sai021/dragon-den/dragon-masks/01-board-photo-reference.png

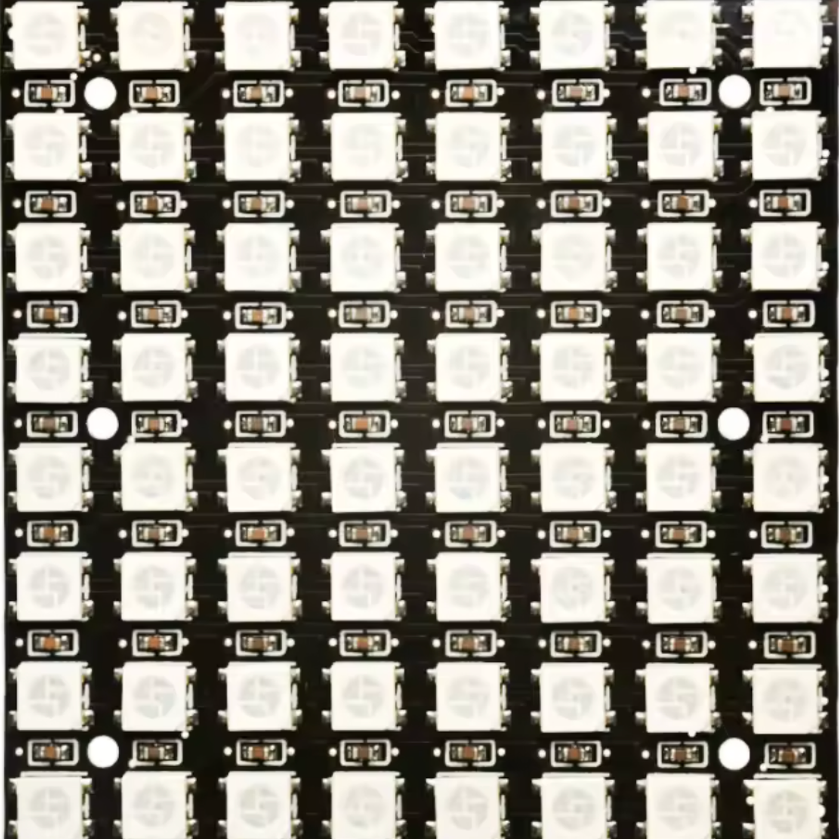
dragon-masks/01-board-photo-reference.png
