sai021/dragon-den/dragon-masks/10-shaded-art-reference.png

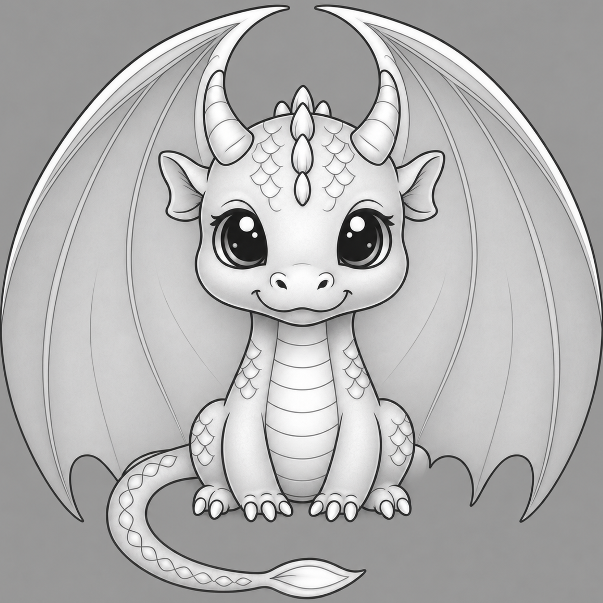
dragon-masks/10-shaded-art-reference.png
