sai021/dragon-den/dragon-firmware/hardware/review-2026-09-21/R4-connection.png

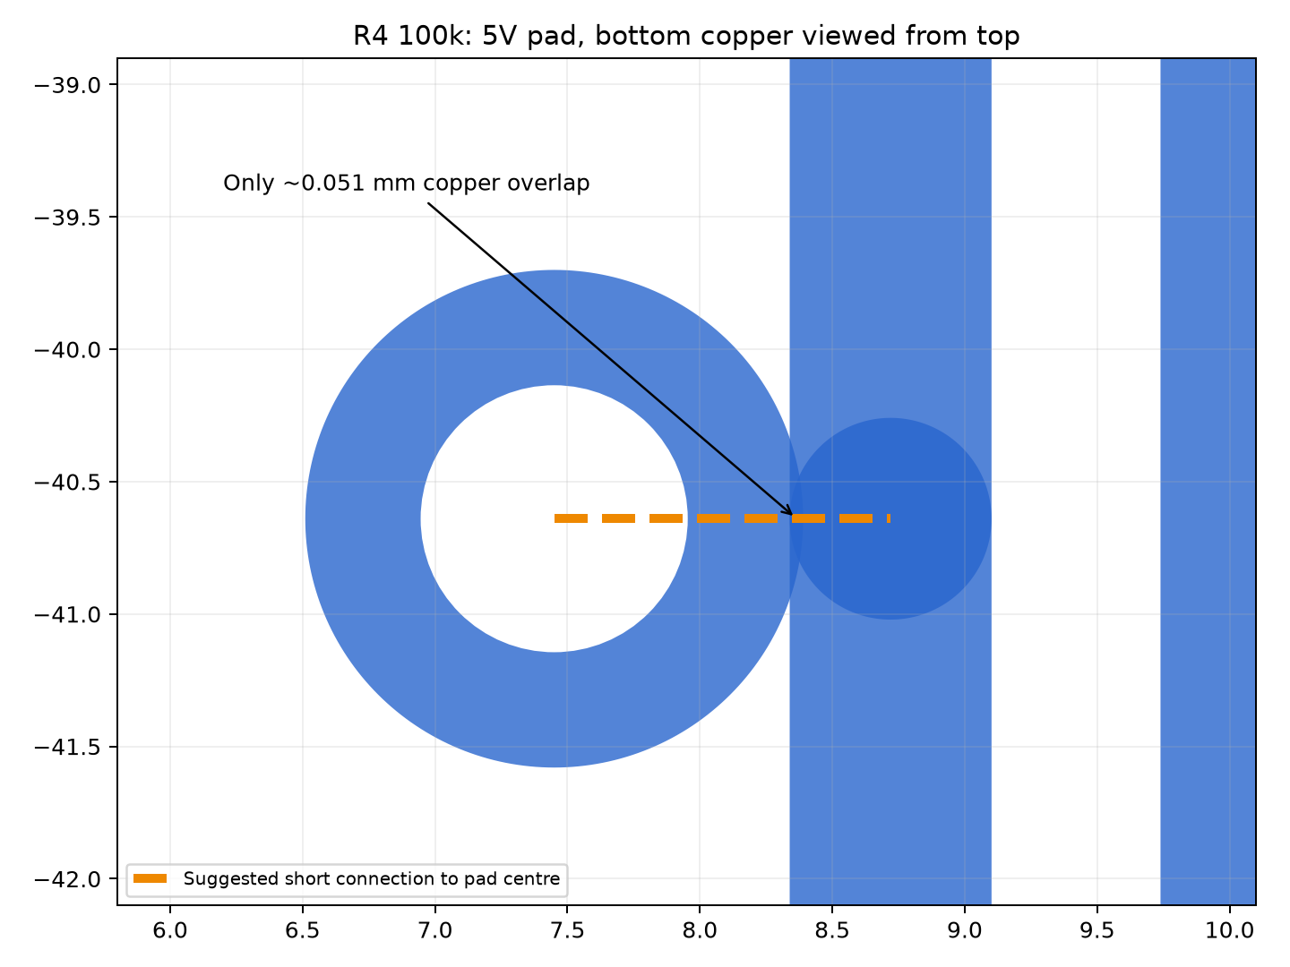
dragon-firmware/hardware/review-2026-09-21/R4-connection.png
