sai021/dragon-den/dragon-masks/01-led-package-mask.png

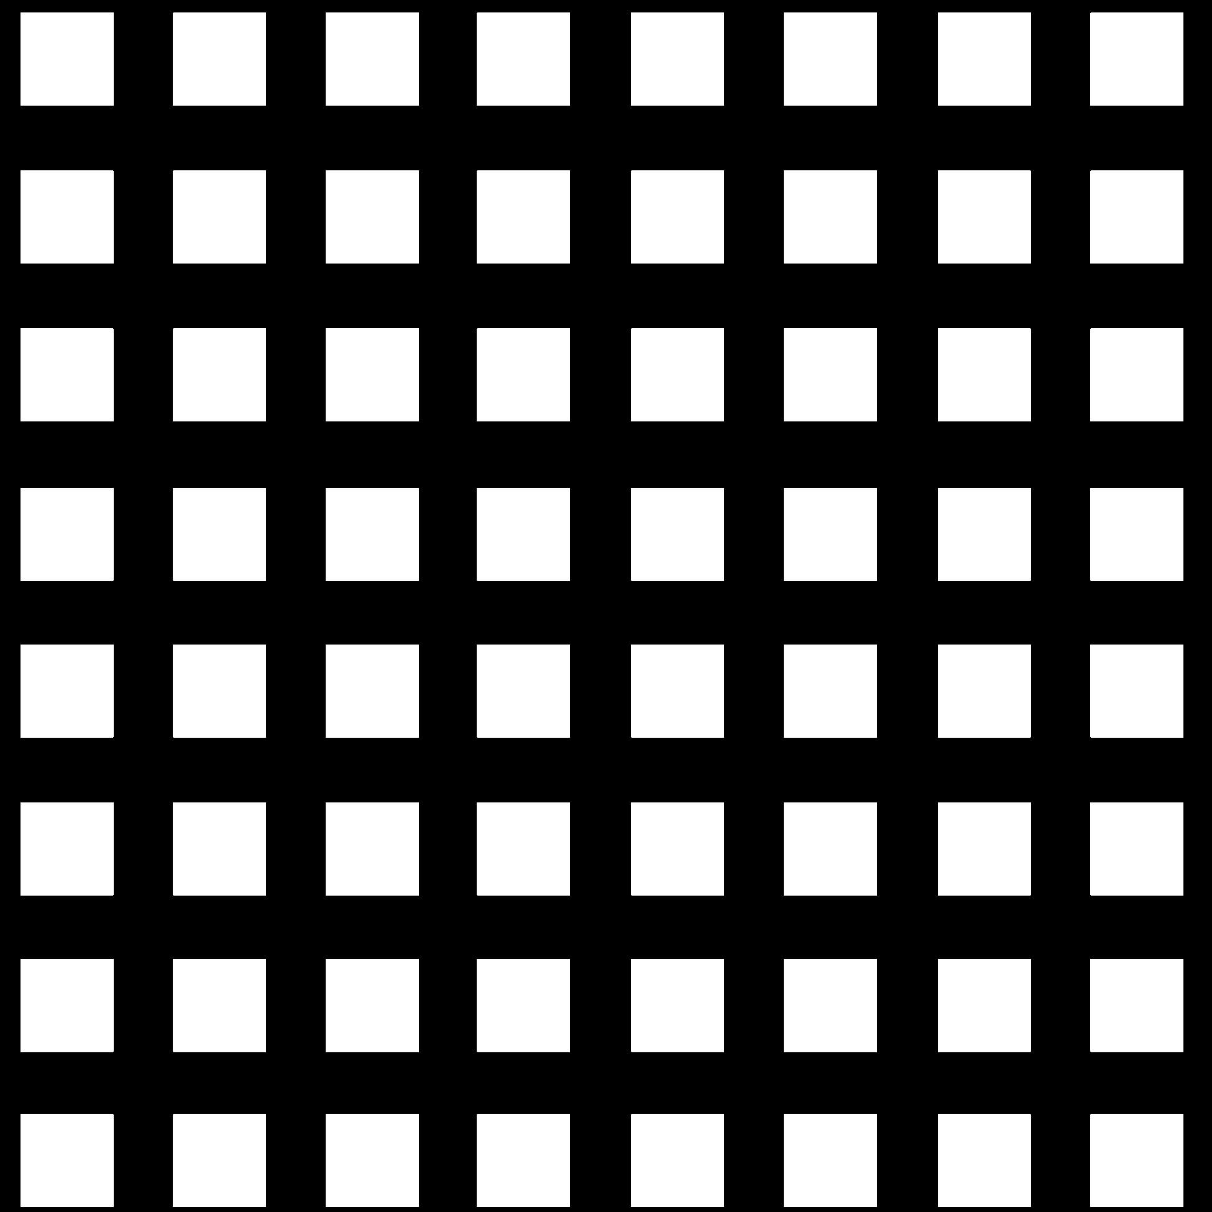
dragon-masks/01-led-package-mask.png
