sai021/dragon-den/dragon-masks/02-led-side-partition-mask.png

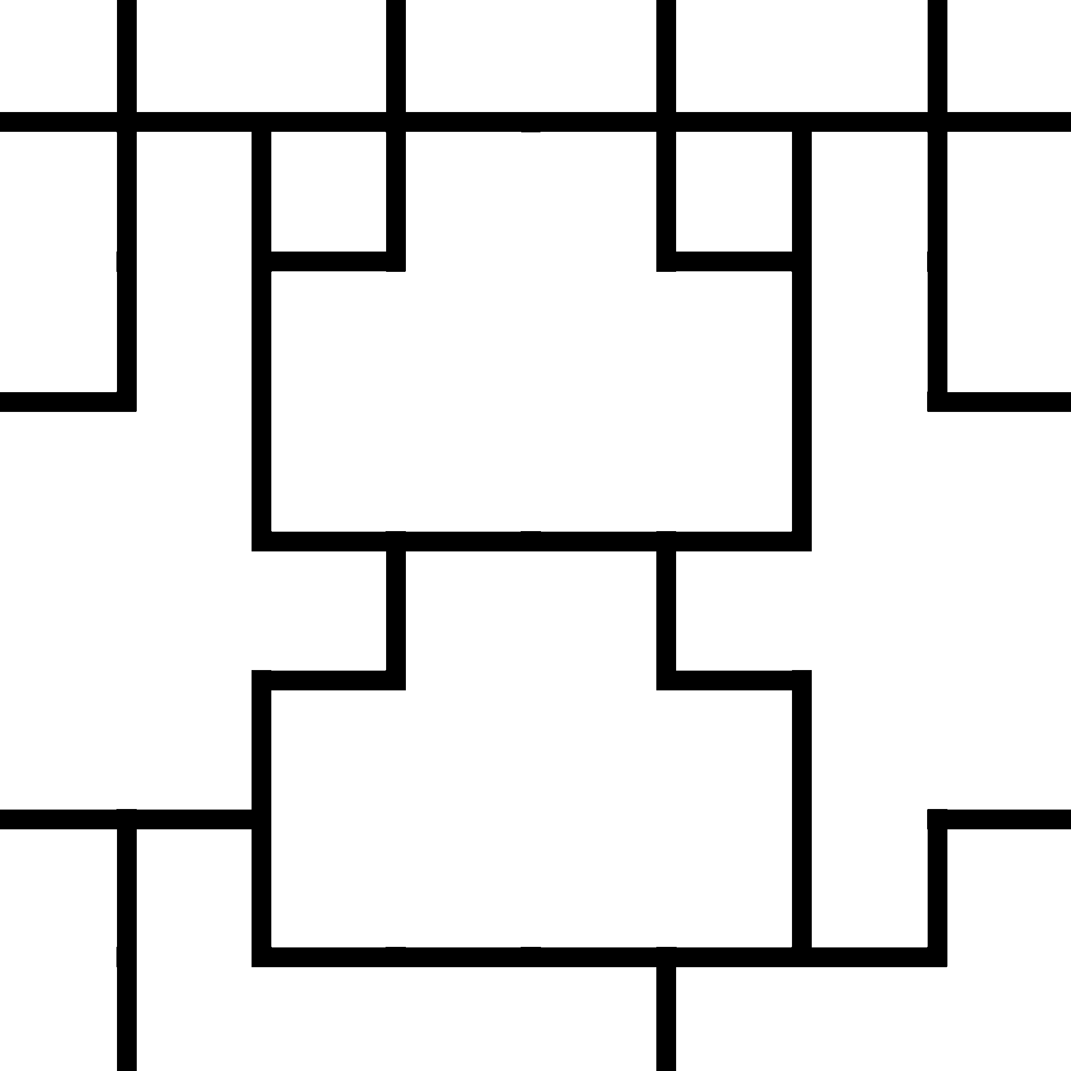
dragon-masks/02-led-side-partition-mask.png
