sai021/dragon-den/dragon-masks/03-lithophane-side-partition-mask.png

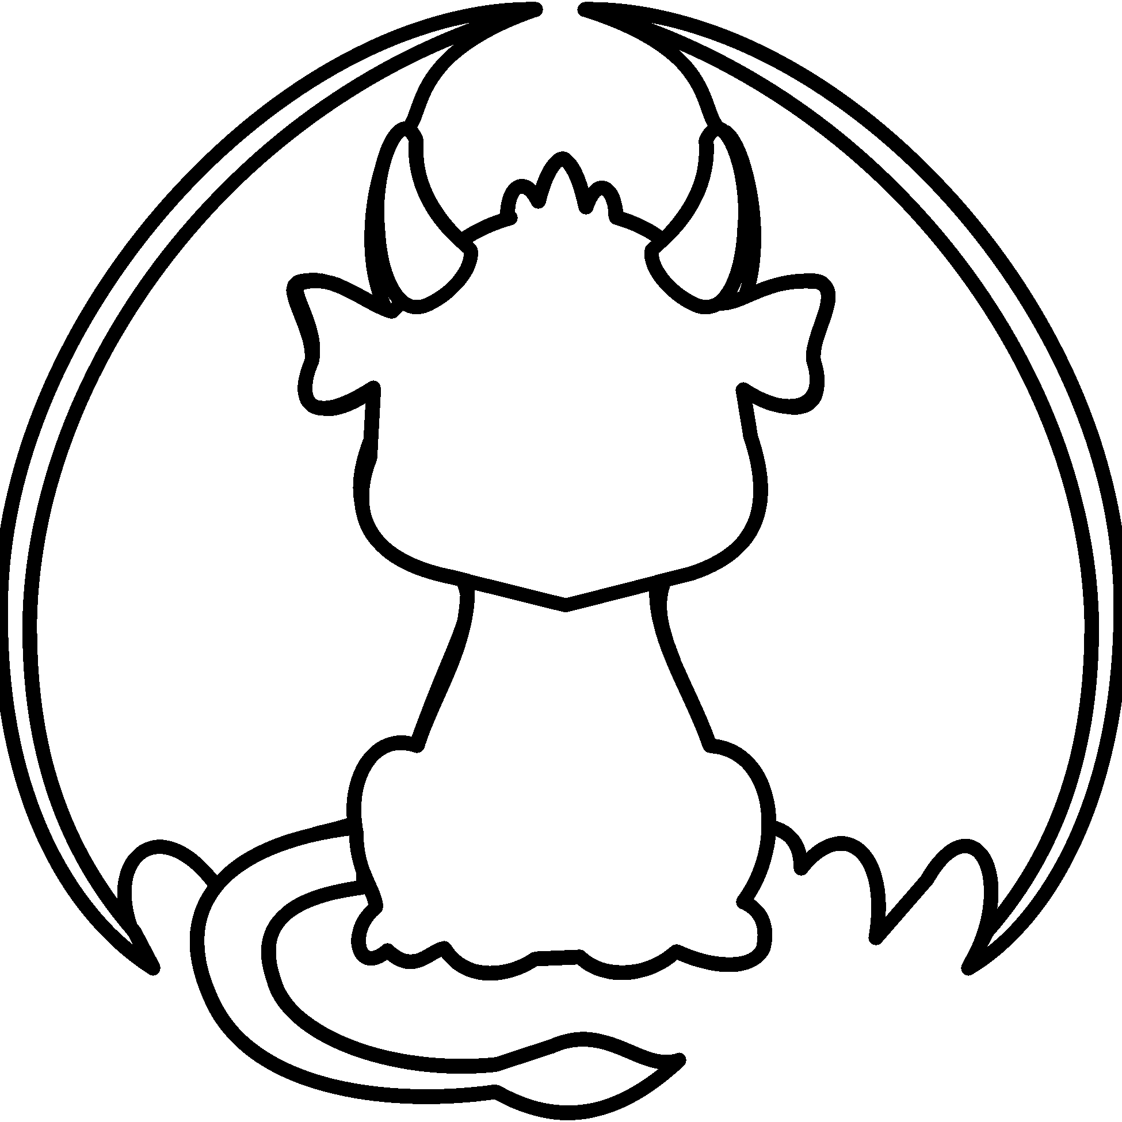
dragon-masks/03-lithophane-side-partition-mask.png
