sai021/dragon-den/dragon-masks/04-dragon-lithophane-input-white-is-thin.png

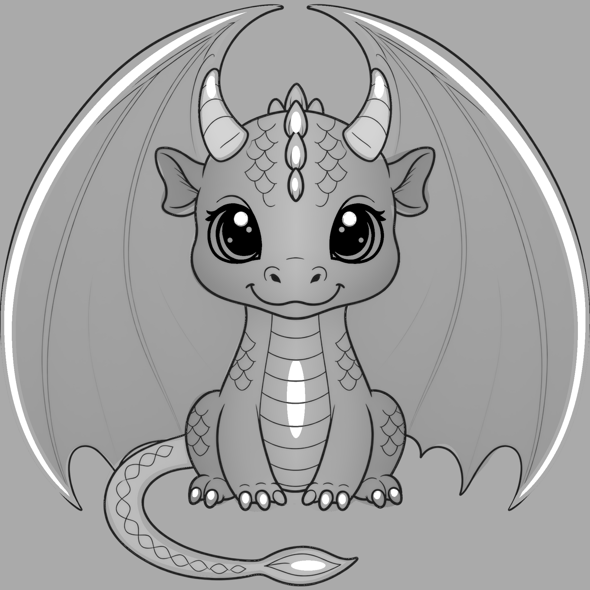
dragon-masks/04-dragon-lithophane-input-white-is-thin.png
