sai021/dragon-den/dragon-masks/05-minimum-0p2mm-highlight-mask.png

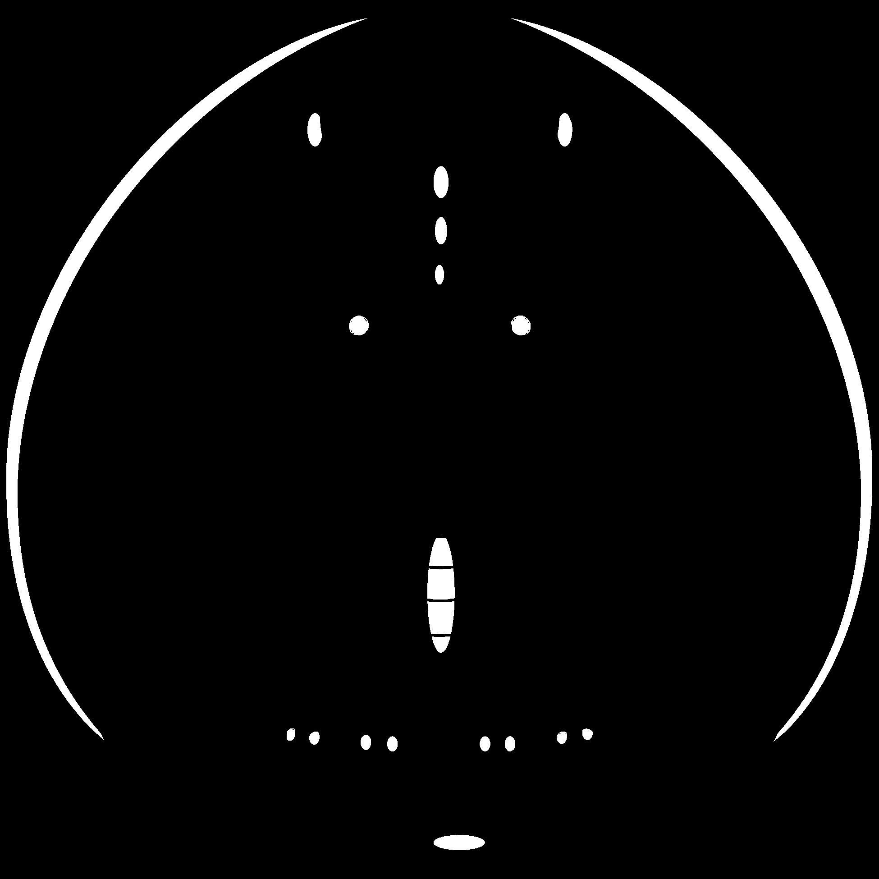
dragon-masks/05-minimum-0p2mm-highlight-mask.png
