sai021/dragon-den/dragon-masks/07-dragon-silhouette-mask.png

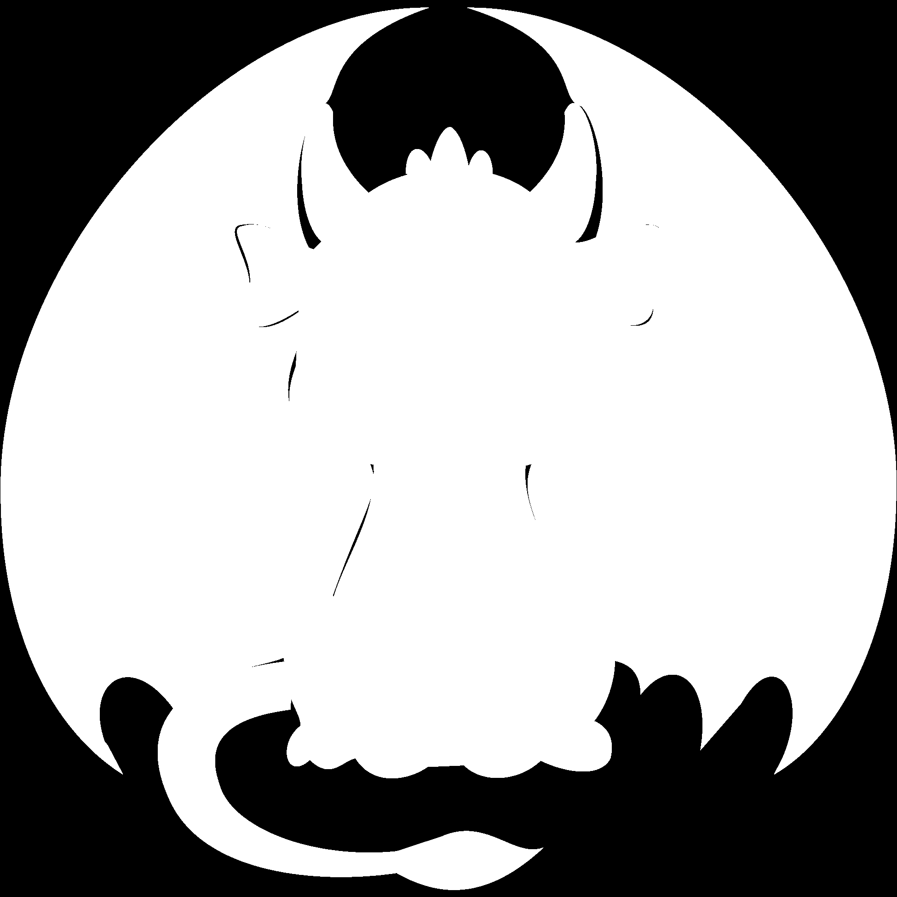
dragon-masks/07-dragon-silhouette-mask.png
