sai021/dragon-den/dragon-masks/08-front-zone-reference.png

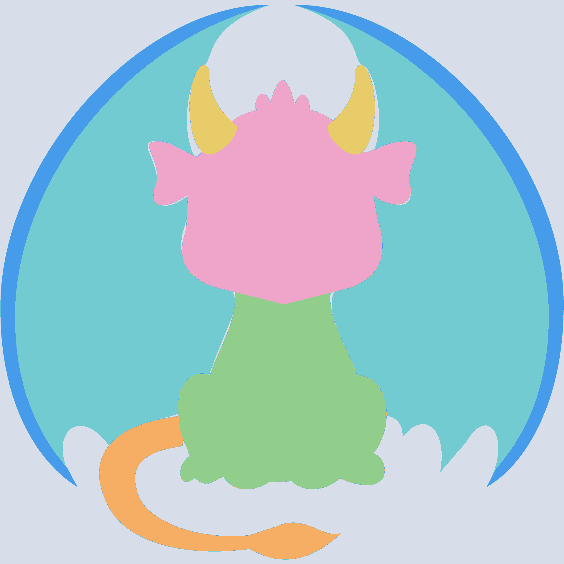
dragon-masks/08-front-zone-reference.png
