sai021/dragon-den/dragon-masks/preview-overview.png

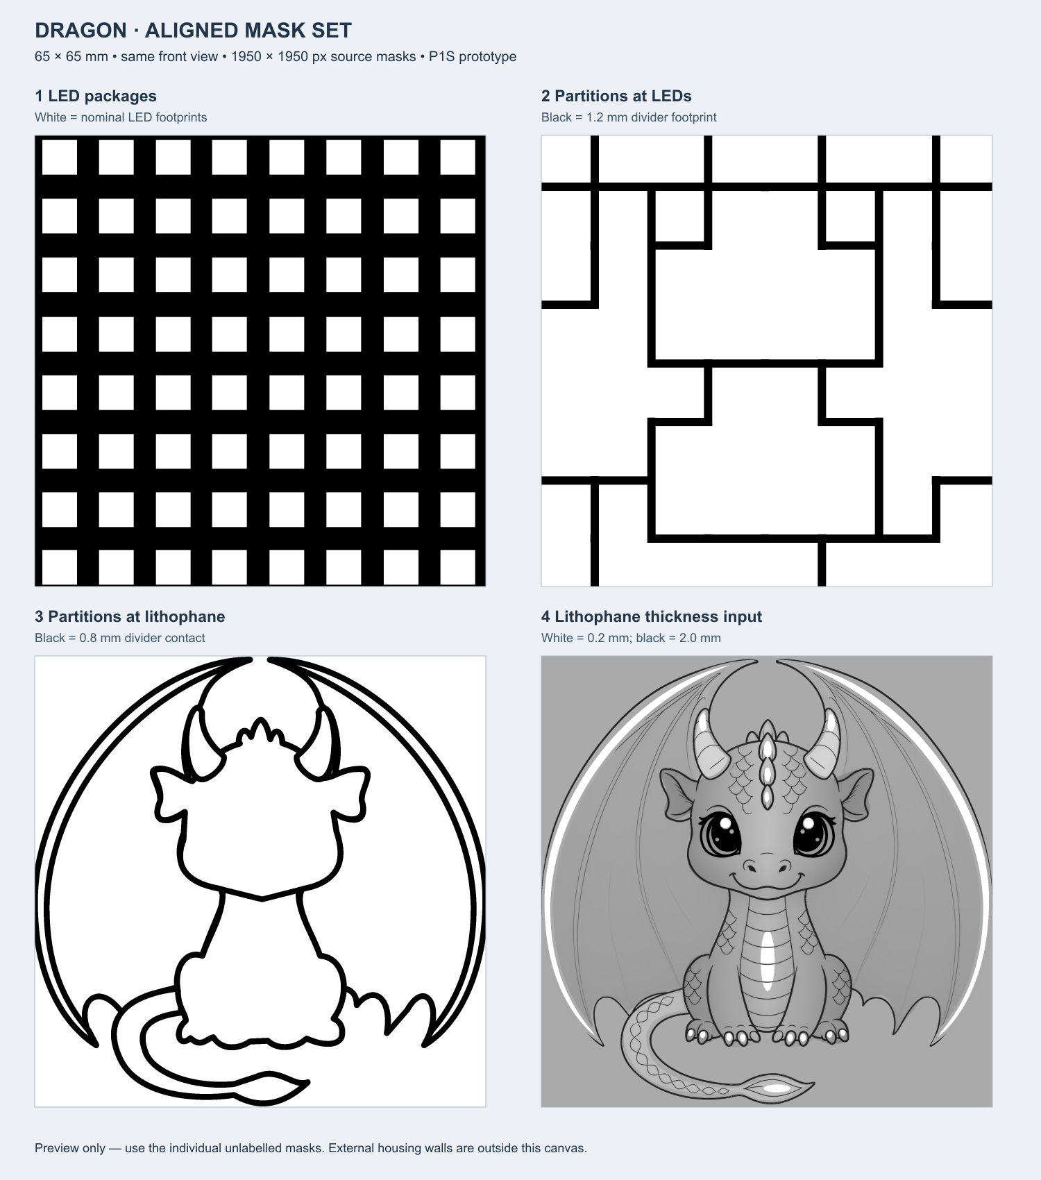
dragon-masks/preview-overview.png
