sai021/dragon-den/dragon-firmware/hardware/easyeda/connections.csv

Part | Terminal | Net
U1 | 5V | +5V
U1 | 3V3 | +3V3
U1 | GND | GND
U1 | GPIO12 | LED_DATA
U1 | GPIO11 | TOUCH_OUT
U1 | GPIO9 | LDR_ADC
U1 | GPIO10 | VBUS_ADC
J1 | VBUS | +5V
J1 | GND | GND
M1 | 5V | +5V
M1 | GND | GND
M1 | DIN | LED_DIN
R1 | 1 | LED_DATA
R1 | 2 | LED_DIN
C1 | PLUS | +5V
C1 | MINUS | GND
U2 | VCC | +3V3
U2 | GND | GND
U2 | OUT | TOUCH_OUT
C2 | 1 | +3V3
C2 | 2 | GND
LDR1 | 1 | +3V3
LDR1 | 2 | LDR_ADC
R2 | 1 | LDR_ADC
R2 | 2 | GND
C3 | 1 | LDR_ADC
C3 | 2 | GND
R3 | 1 | +5V
R3 | 2 | VBUS_ADC
R4 | 1 | VBUS_ADC
R4 | 2 | GND
C4 | 1 | VBUS_ADC
C4 | 2 | GND
