sai021/dragon-den/dragon-masks/06-black-eye-material-mask.png

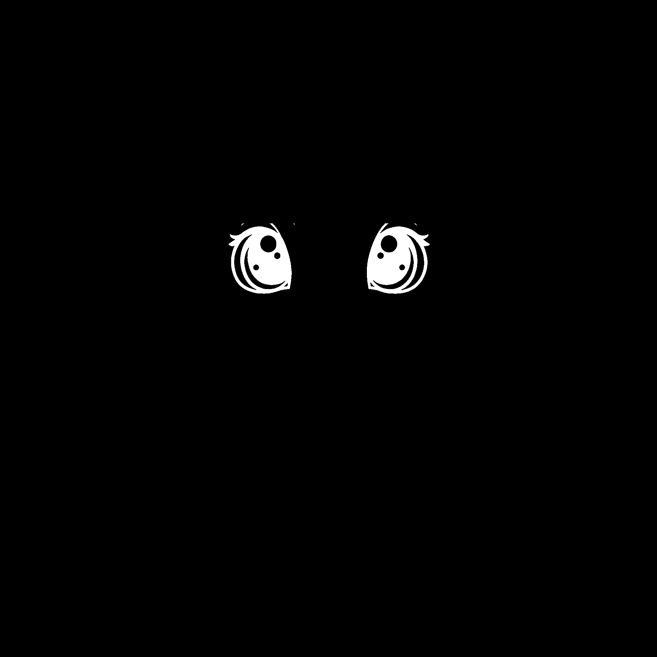
dragon-masks/06-black-eye-material-mask.png
