sai021/dragon-den/docs/USER-MANUAL.md

# Dragon Den

User manual

For young dragon keepers and their grown-ups

## Welcome to your dragon

Choose a dragon, give it some magic, or create one of your own. You can play
with the touch pad on the dragon or use a phone browser. No app or coding is
needed. Ask a grown-up to help with power and the first phone connection.

## Start playing

1. Ask a grown-up to connect the power supply supplied or specified by your maker.
2. Wait for startup to finish. Blue pulses are normal while the dragon starts.
3. Tap the touch pad to choose the next dragon.
4. Double tap to put your dragon to sleep or wake it.
5. Hold the pad to change its glow. Release, then hold again to change direction.

## Your three touch moves

- **Tap:** next dragon, or wake from sleep.
- **Double tap:** sleep or wake.
- **Hold:** adjust glow in small steps.

Touch play works without a phone or internet. A new, empty profile needs some
favourites or a creation before there is a dragon to play with.

**Keep your setup card.** It has your dragon's Wi-Fi name and password. 

<!-- page -->

# Connect a phone

First setup - a grown-up's job

## Open Dragon Den

1. Power the dragon and wait for startup to finish.
2. Open the phone's Wi-Fi settings. Join the dragon network named on its setup card.
3. Enter the password from the card.
4. If the phone says this network has no internet, choose to stay connected.
5. Open a browser and type **http://192.168.4.1** in the address bar.
6. When asked to log in, use **parent** and the same password from the card.

The page may open automatically. If it does not, use the address above.
You can play while connected directly to the dragon. Home Wi-Fi is optional.

## Optional: connect to home Wi-Fi

1. Open **For grown-ups · Wi-Fi & help**.
2. Tap **Find my Wi-Fi**, then choose your network in the Wi-Fi name box.
3. Enter its password. Use **Show password** if you want to check your typing.
4. Tap **Connect my dragon** and wait for the result.
5. After success, rejoin home Wi-Fi on the phone. Open the dragon address shown
   on the page and save it as a bookmark.

Choose a **2.4 GHz** home network. If it is not listed, type its name yourself.
If the password is incorrect, check it and try again. Use the dragon address
displayed on your own page; different dragons have different addresses.

<!-- page -->

# Choose your collection

Profiles and favourites

## All or a personal profile

Use **My profile** to switch collections. **All** contains every supplied
dragon and every saved creation. It cannot be renamed or deleted.

A named profile contains its saved favourites plus creations made in that
profile. **My dragon** shows only that collection. The first item is selected
when the dragon starts, and single taps cycle through the same collection.

## Make a profile

1. Open **My favourites & starting glow**.
2. Enter a **New profile name** and tap **Add profile**.
3. Tick the dragons you want as favourites. You can choose up to **12**.
4. Choose the **Starting glow**, then tap **Save profile**.

Favourites use the order in which you tick them. Untick and tick one again to
move it to the end. Your own creations appear after the other favourites.
A new empty profile says **Add favourites or make a dragon**.

There are **three named profile spaces**, plus All. Profiles and saved creations
are kept when power is disconnected. Temporary play effects are not saved as
the profile's startup settings.

## Delete a profile

Select the named profile, open its settings, and tap **Delete this profile**.
Read the confirmation before agreeing. Its custom dragons move into **All**,
and the profile space becomes available again. All is protected.

<!-- page -->

# Make your own dragon

Colours, parts and magic

## Create and save

1. Tap **Make a dragon** and choose **Start from**.
2. Enter a **Dragon name**.
3. Tap a part in the picture, or choose it from **Dragon part**.
4. Choose its **Colour** and **Magic on this part**.
5. Repeat for other parts, then tap **Save my dragon**.

You can change the face, body, tail, horns, wing edges, wing interiors and
background separately. Parts you leave alone keep their original colours and
patterns. **Use original colour for this part** restores that part's base colours.

The picture shows the layout of the dragon's 64 lights. It is a still colour
preview. Save to see the result on the real dragon; room light and available
power can make the real glow look different.

## Edit, copy or cancel

- Select your creation in **My dragon**, then tap **Make a dragon** to edit it.
- **Save my dragon** replaces a creation you own.
- **Save a new copy** keeps your earlier creation as well.
- Editing a supplied dragon, or another profile's creation, makes your own copy.
- **Cancel** discards the draft without changing the saved dragon.

There are **eight custom dragon spaces shared across all profiles**. If they
are full, edit an existing creation or delete one you own after confirming.
Deleting a creation also removes it from favourites. Supplied dragons stay.

## Play some magic

On the play screen, try **Glitter**, **Fire**, **Breathe** or **Rainbow**. An
effect continues until you change it. Tap **Back to my dragon** to restore its
normal colours and region effects. **Glow** changes brightness; the sleep
button changes to **Wake my dragon** when the dragon is asleep.

<!-- page -->

# Reconnect and get help

Changing Wi-Fi or solving a problem

## Reopen setup

1. Disconnect power from the dragon.
2. Hold the touch pad while reconnecting power.
3. Keep holding through the blue startup pulses.
4. Release when the purple setup indication appears after startup.
5. Join the dragon network using its setup card and open **http://192.168.4.1**.

This keeps the saved home Wi-Fi details. To remove them, use **Forget home
Wi-Fi** in the grown-ups area and confirm. Then rejoin the dragon network.
Your creations and setup-network password are kept.

## Quick troubleshooting

- **The phone says "no internet".** This is normal on the dragon's own network.
  Choose to stay connected and open the setup address in a browser.
- **The page stopped responding after Wi-Fi setup.** Rejoin home Wi-Fi on the
  phone, then use the dragon's displayed address or your saved bookmark.
- **A profile has no dragons.** Add favourites and save, or make a dragon.
- **The dragon is dark or dim.** Check sleep and Glow first. It dims in a dark
  room and may switch off in very bright daylight. Move it into ordinary room
  light and allow a few seconds to adjust.
- **Home Wi-Fi is unavailable.** Touch play still works. The dragon retries its
  saved network. Reopen setup with the power-on hold if you need phone control.
- **Repeated red flashes or restarting.** Ask a grown-up to disconnect power
  and contact the maker. Do not open the product or change its wiring.
- **The setup card is missing.** Contact the maker. A parent-operated password
  reset is not available in this version.

<!-- page -->

# Keep this page handy

Care, reminders and your device details

## A grown-up connects the power

Use the power supply supplied or specified by the maker. Keep the dragon dry
and handle its cable gently. Ask a grown-up for help if a connector or cable
is damaged. Do not open the enclosure or connect extra power sources.

For a prototype connected to a computer: **laptop USB and external/main power
must not be connected at the same time**. The maker should handle any computer
testing or wiring changes.

## Remember

- No app or coding is required for normal use.
- Touch play does not need internet.
- Keep the setup card and bookmark the phone-control address.
- All is the complete collection; named profiles are personal collections.
- Save your profile or creation before disconnecting power.
- Glow is adjusted for room light and available power. A 100% setting does not
  override those adjustments.

## My dragon details

Dragon name: __________________________________________

Phone-control bookmark: _________________________________

Maker/contact: _________________________________________

Keep passwords on the separate setup card, not in a shared copy of this manual.

**About this edition:** Dragon Den prototype user manual, version 0.1,
15 October 2026. It describes the current interface. The enclosure and printed
parts are still being developed, so your maker will provide any model-specific
power and care instructions.
