sai021/dragon-den/docs/PARENT-GUIDE.md

# Using Dragon Den

This guide is for a family with a prepared prototype and its printed setup card.
No app, account or coding is needed for normal play.

## Touch play

| Gesture | Action |
| --- | --- |
| Single tap | Next dragon in the active collection; wake if asleep |
| Double tap | Sleep or wake |
| Hold | Adjust glow in 10% steps; release and hold again to reverse direction |

The dragon also responds to room light. Its glow is limited by the available
power, so 100% does not necessarily mean the LEDs' maximum possible output.

## First phone connection

1. Plug in the prepared dragon and wait for startup to finish.
2. Join the dragon Wi-Fi network shown on its setup card.
3. If the phone warns that the network has no internet, choose to stay connected.
4. Open `http://192.168.4.1` in the phone browser.
5. Log in as `parent`, using the setup card's password.

Play directly through this network, or open **For grown-ups · Wi-Fi & help**.
**Find my Wi-Fi** offers nearby 2.4 GHz home networks. Choose a network or type
its name, enter its password, and connect. After success, rejoin home Wi-Fi and
use the dragon address displayed on the page. Save that address as a bookmark.
Home Wi-Fi is optional. Internet features are not required for ordinary play.

## Profiles and creations

**All** shows the complete collection and cannot be renamed or deleted. Add a
named profile in **My favourites & starting glow**. Choose its favourites and
starting glow, then save. **My dragon** shows those favourites plus the
profile's own creations. A new empty profile invites you to add or create one.

To create, tap **Make a dragon**, choose **Start from**, and give it a name.
Tap a part in the picture or use the part list. Change its colour and magic.
Wing edges and interiors can be different. Save to see the creation on the
physical dragon. Cancel leaves the device unchanged.

You can edit a creation you own or save a new copy. The original supplied
dragons remain intact. Deleting a profile moves its creations into All.
There are three named profile spaces and eight custom dragon spaces.

## Reconnect or change home Wi-Fi

Hold the touch pad while plugging in. Keep holding through the blue startup
pulses, then release when the purple indication appears. Join the dragon
network using the card and reopen `http://192.168.4.1`.

**Forget home Wi-Fi** opens setup again and removes the saved home-network
details. It keeps the dragon's setup password and creations. A router outage
does not stop touch play or automatically open a new setup network.

## Prototype testing

This is the current prototype guide, not a finished consumer-product manual.
For the developer's laptop test, external/main power stays disconnected. Do
not connect laptop power and main power simultaneously with the current circuit.
Follow the prepared device's power instructions rather than changing its wiring.

Keep the setup card: replacing a lost setup password through a parent-friendly
factory-reset flow has not been implemented.
