sai021/dragon-den/dragon-firmware/hardware/review-2026-09-20/assembly-map.png

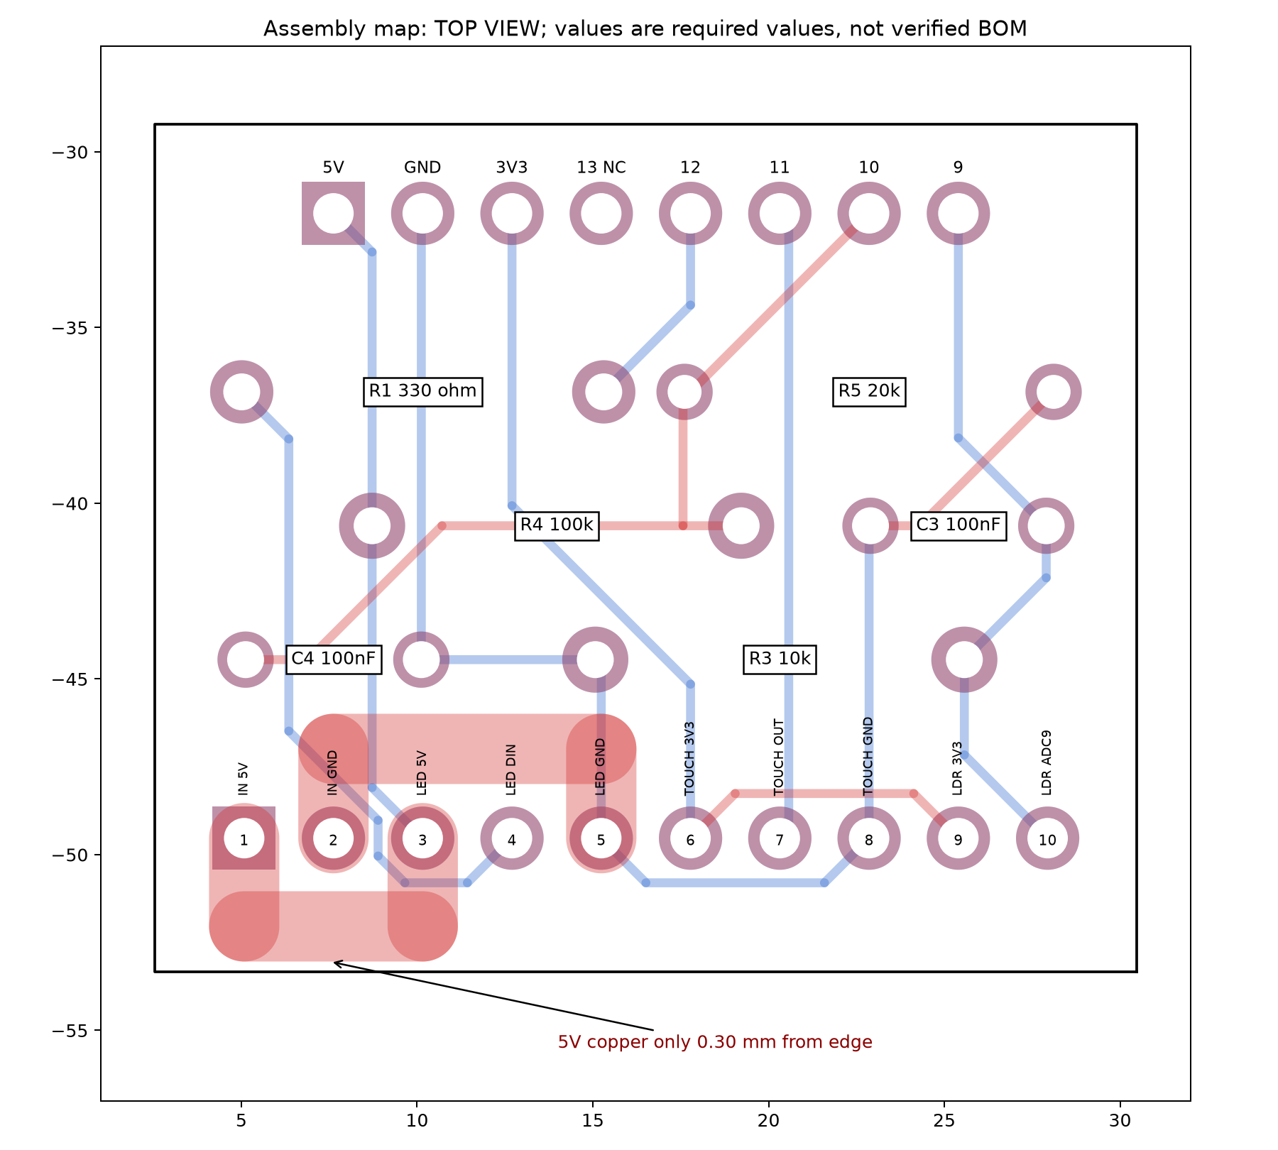
dragon-firmware/hardware/review-2026-09-20/assembly-map.png
