sai021/dragon-den/dragon-firmware/hardware/review-2026-09-21/manufactured-appearance.png

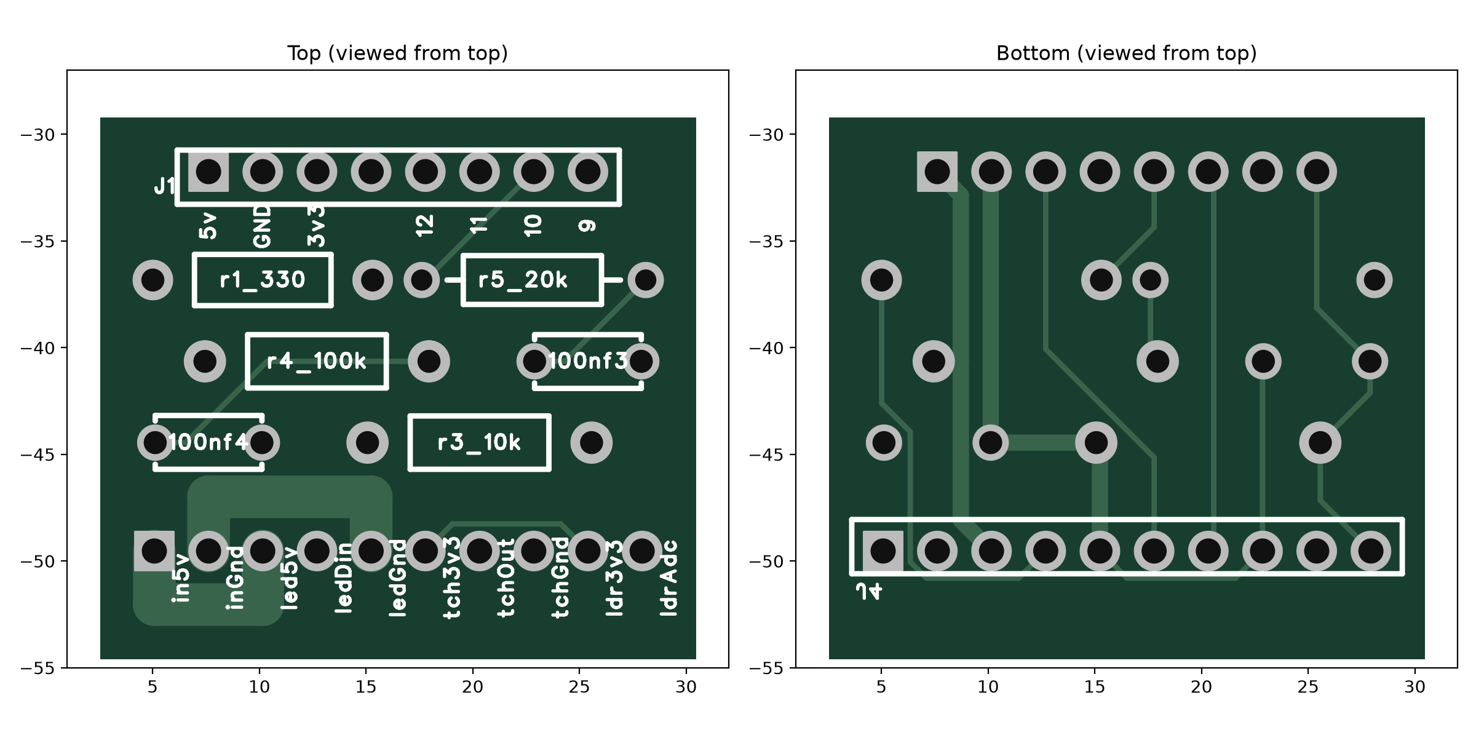
dragon-firmware/hardware/review-2026-09-21/manufactured-appearance.png
