sai021/dragon-den/dragon-masks/light-guide/preview.png

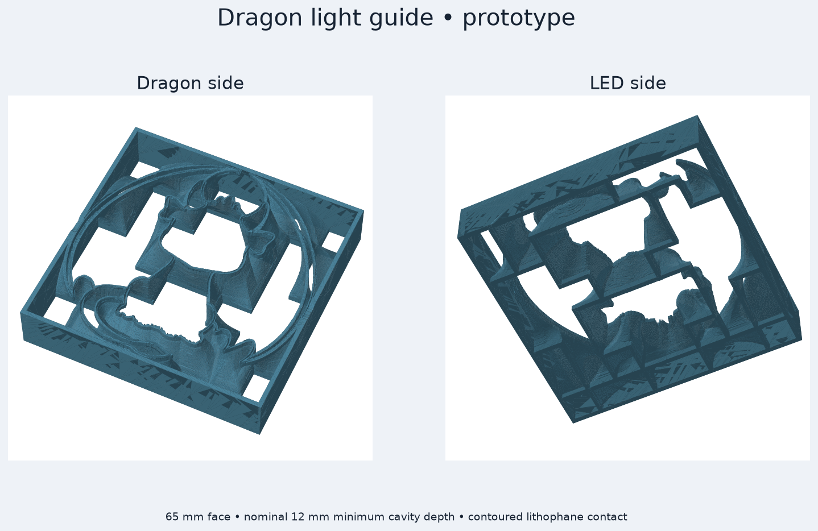
dragon-masks/light-guide/preview.png
