sai021/dragon-den/dragon-masks/light-guide/sections.png

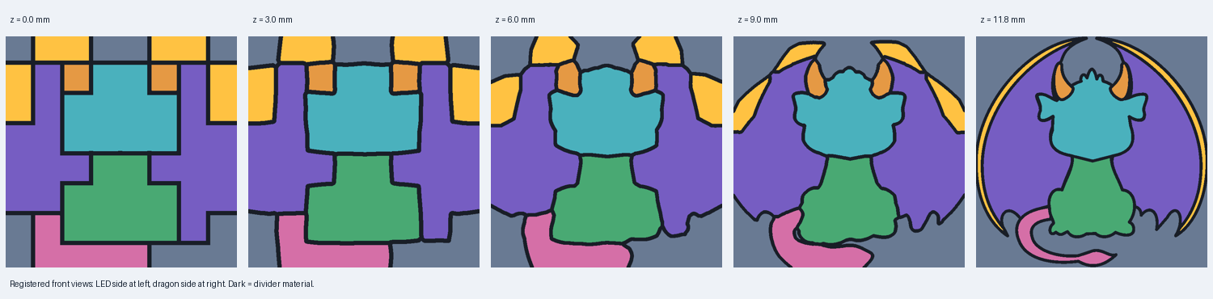
dragon-masks/light-guide/sections.png
