sai021/dragon-den/dragon-masks/09-thickness-test-strip.png

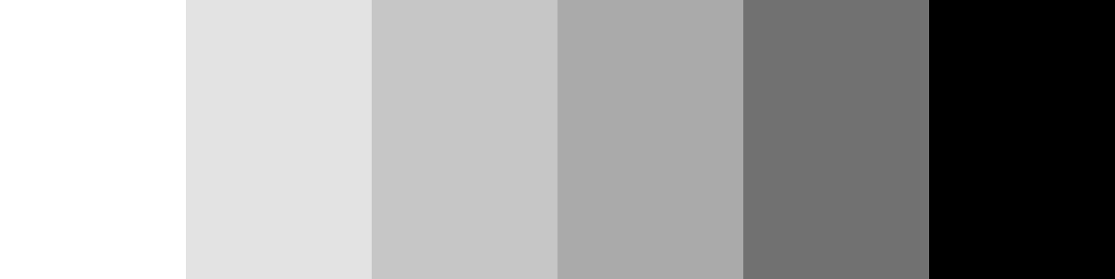
dragon-masks/09-thickness-test-strip.png
