sai021/dragon-den/CHANGELOG.md

# Changelog

## 0.1.0-prototype — 15 October 2026

Initial consolidated project checkpoint for Dragon Den.

- ESP32-S3 touch/ambient controls, 81 supplied palettes and bounded animations.
- Offline phone interface, Wi-Fi provisioning, retry and deliberate setup recovery.
- Protected All, three named profiles, filtered collections and ordered favourites.
- Eight persistent custom dragons with independent region colour/effect editing.
- Creation copy/delete, profile deletion retaining creations in All, and checked
  alternating storage snapshots.
- Fixed reproduced networking startup crash with the core's event callback lock.
- Retained laptop USB's 400 mA estimated ceiling and the separate deployed
  external-supply arrangement.
- Consolidated developer/parent guides, architecture/API, provenance and test status.
- Preserved earlier optical/CAD sources and reviews as prototype history.

Newer printed STL designs, making-of photos and final Gerbers are awaiting the
user's later delivery. Weather, parent PIN, lost-card recovery, portable backup
and web firmware updates are not part of this checkpoint.
