sai021/dragon-den/(commit log)

2026-10-14 Initial Dragon Den prototype and consolidated project handover
2026-10-14 Add printable end-user manual and editable source
